tlouwers/buildserver-monitor/buildserver-endpoint/README.md

# buildserver-endpoint
Contains the C/C++ code for the endpoint, the Wemos Lolin D1 mini Pro device.

# buildserver-server
Contains the C# code for the server and (test) client. The server is used to control the endpoint, the client mimics the endpoint and is used for testing.
