tlouwers/buildserver-monitor/buildserver-monitor/manuals/Readme.md

# Information
This folder contains the manual with instructions how to:
* install the development environment
* solder the hardware components
* construct the buildserver monitor kit in general
* program the firmware
* list of components used

##
Documentation is written in LibreOffice v6.4, intended as large word document.
