tlouwers/buildserver-monitor/buildserver-endpoint/manuals/Buildserver-server.odt

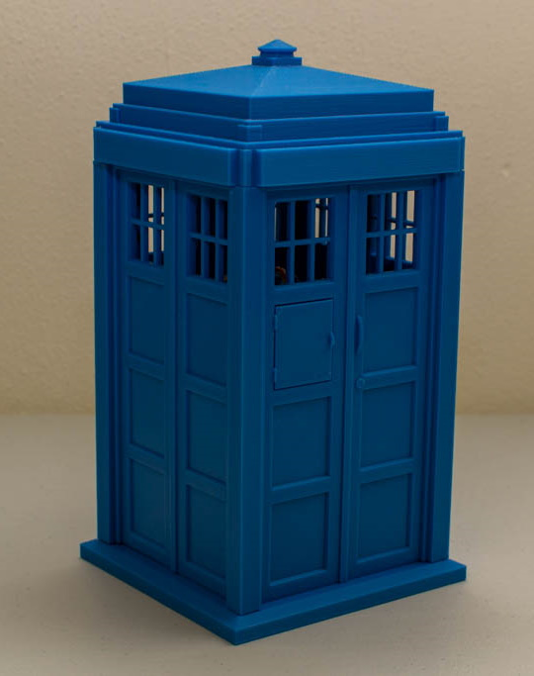
[picture p1: figure]

Buildserver-endpoint

# Idea and intent

To make better use of the buildserver-monitor, this document describes some upgrades made to the already build system. Consider this a version 2.

By adding some hardware components features are added: a buzzer, a vibration motor and an OLED screen. By changing the behavior in software the buildserver-monitor becomes a buildserver-endpoint: instead of the device polling a Jenkins buildserver it becomes a TCP client which connects to a server application. This server application can use a defined API to send commands to the buildserver-endpoint, things like: turn led 3 on in color blue and with 40% brightness. Or, turn buzzer on for 500 milliseconds, then 500 milliseconds silence and repeat for 10 times.

An example server application is provided to show how this API is used. It can control a single buildserver-endpoint, although other server application may support many clients at once.

# Build Environment

To make development more pleasant a switch from Arduino IDE (https://www.arduino.cc/en/software) to PlatformIO (https://platformio.org/platformio-ide) is made. PlatformIO is a plugin for Visual Studio Code (https://code.visualstudio.com/), a description how to install it can be found here (https://docs.platformio.org/en/latest/integration/ide/vscode.html#ide-vscode).

The buildserver-endpoint firmware is build using this IDE.

For the example Server application C# is used (on Windows). For this an old version of Visual Studio Community (2013) (http://go.microsoft.com/?linkid=9863609) is used in combination with a single package (MetroModernUI (https://www.nuget.org/packages/MetroModernUI)) to make the interface look a bit better.

The intent is for the user to write a server application in the language of choice: this is the fun part as you now have full control of the buildserver-endpoint.

# Battery

According to the ESP8266EX datasheet the ESP chip has a single ADC input pin (TOUT), which

can measure a range of 0..1,0V with 10 bit precision.

The Wemos Lonin D1 mini Pro has this pin connected via a voltage divider (see the schematic):

A0 - this is the pin the user can measure, this is in range 0..3,2V

ADC - this is the pin on the ESP chip, this is in range 0..1,0V

The pin ADC (or TOUT) can be found in the schematic of the Wemos board here (https://www.wemos.cc/en/latest/_static/files/sch_d1_mini_pro_v2.0.0.pdf).

To measure the battery we make use of a voltage divider on the board which brings the battery voltage (between 0V and 4.2V) into the range the ADC pin can handle.

When looking in the schematic (See the Battery segment) there are 2 ways to get a voltage on the ADC pin:

- Do NOT connect SJ1 (2 pads on the back of the board). This allows use of the A0 pin, which has a range of 0V .. 3.2V, the voltage divider R1 and R2 brings this into range for the ADC pin.

See: https://www.allaboutcircuits.com/tools/voltage-divider-calculator/

In the schematic of the website Vin is A0, Vout is ADC.

- Connect SJ1 (2 pads on the back of the board). This allows use of Vbat (the actual battery voltage) which is put via the voltage divider to ADC. Here resistor R17 is put in series with R1 (added to, effectively making it a single resistor). Pin A0 should not be used.

The default for measuring the battery is connecting SJ1.

The range (Vbat) becomes 0V .. 4,5V. The charger circuit will make sure the battery charge does not go above 4,2V for the LiPo battery.

Calculating the ADC count:

Count = (Vout * ADCbits) / Vmax_adc --> Count = (Vout * 1023) / 1,0V

To get from ADC count back to the actual battery voltage, we can use the following formula:

V = Count * (Vmax_adc / ADCbits) --> V = Count * (1,0V / 1023)

As we do not want to know the voltage on the ADC pin, we multiply with Vmax_bat, the maximum

voltage as available on Vbat. V = Count * (Vmax_adc / ADCbits) * Vbat --> V = Count * (1,0V / 1023) * 4,5V --> V = Count * 0.0043988270

To map this to a % full lookup table is used where the battery characteristics are included.

Typically, a LiPo battery is considered full at 4,15V, the electronics starts to fail around 3,4V and

the internal battery protection will disconnect the battery at 3,0V. This means we map the % full

on a range of 4.15V (100% full) down to 3,4V (0% full).

https://www.electro-tech-online.com/threads/linear-interpolation-and-lookup-tables-c.147507/

If using linear interpolation on a single segment, we can use a simplified calculation:

float interpolate_segment(float x0, float y0, float x1, float y1, float x)

{

float t;

if (x <= x0) { return y0; }

if (x >= x1) { return y1; }

t = (x-x0);

t /= (x1-x0);

return y0 + t*(y1-y0);

}

With x0 as 3,4V, x1 as 4,15V, y0 as 0% and y1 as 100%, it now becomes:

float calculate_percentage(float x)

{

if (x <= 3.4) { return 0.0; }

if (x >= 4.2) { return 100.0; }

return ( (x - 3.4) / (4.15 - 3.4) ) * 100;

}
