tlouwers/buildserver-monitor/buildserver-endpoint/manuals/Readme.md

# Information
This folder contains the manual with instructions how to:
* install the development environment
* use the buildserver-monitor hardware in a different way
* program the firmware for the buildserver-endpoint
* provide an example Server application in C#
* use the API to be able to control the buildserver-endpoint

##
Documentation is written in LibreOffice v7.3, intended as large word document.
