tlouwers/buildserver-monitor/(commit log)

2020-01-28 Create initial application structure.
    Add various classes: logging, leds, application, statemachine.
    Add statemachine and move handling into Application class.
    Add gitignore file.
    Add doxygen configuration file.
    Update demo to display some colors on a 5 pixel strand.
2020-01-28 Add doxygen comments.
    Add check for the leds if they initialized, before taking an action on the library used.
    Rename folder to allow using the Arduino IDE directly from the *.ino file in the repository.
2020-01-29 Add separate 'wifi_config' file.
    Take maximum wifi connect timeout into account.
    Increase NeoPixel strand length to 8 (default).
    Add delay when encountering Error state.
    [Application.cpp, WifiConnection.cpp, config.h, wifi_config.h]
2020-01-30 Add FakeLeds simulation class.
    Add option to use either real or simulated leds.
2020-01-31 http request, json parsing and displaying
    can send a http request to jenkins and receive a job status in json format. this json can then be parsed and the leds can be turned on accordingly.
2020-02-03 removed prints, improved naming, added destructor delete and added http configuration validation
2020-03-02 Add BOM (bill of material) document.
2020-03-02 Add Power Circuit document.
2020-03-24 Initial NeoPixel assembly document.
2020-04-30 Add photos of the ESP-01 and USB programmer board.
2020-05-12 Improve board manager url picture.
2020-06-02 Remove some magic numbers (make them configurable).
    Close WiFi and reset on error. Initial state diagram added to Architecture document.
    [Application.cpp, Application.hpp, timings.hpp]
2020-07-02 Fix possible null dereference and some spelling items in the Architecture document.
    [WifiConnection.cpp]
2020-09-08 Merge documents together, this to be easier to read.
    Added a section on how to connect the LED strand with the power circuit and added a switch to turn the power on/off.
2020-12-15 Add assembly photos
    Also update descriptions such that only 4 instead of 8 leds are used.
2022-05-09 Update after HW switch to Wemos D1 mini Pro.
    Minor code updates, doxygen fixes.
    Initial document update due to simplified electronics.
    [Application.cpp, FakeHttpClient.hpp, FakeWifiConnection.hpp, IHttpClient.hpp, ILeds.hpp, ILogging.hpp, config.h]
2022-05-10 Update the manual with more assembly photos.
    Add light sleep mode, poll build status once per minute. Spelling fixes, cleanups, make error status more clear to user.
    [Application.cpp, Leds.cpp, Logging.cpp, WifiConnection.cpp, httpClient.cpp, http_config.h, timings.hpp, wifi_config.h]
2022-05-12 Handle authentication properly, fix JSON parsing.
    Robustness improvements and code cleanups. Update documentation.
    [Application.cpp, Application.hpp, FakeLeds.hpp, Leds.cpp, Leds.hpp, Logging.cpp, Logging.hpp, StateMachine.hpp]
2022-05-13 Implement light sleep mode to save power.
    Dim the leds a bit to save power.
2022-05-13 Update BOM in documentation.
2022-05-19 Add led status description to manual
2022-05-19 Add section on how the measure the battery and get to a % full.
2022-05-20 Intermediate commit to start with folder structure for the endpoint.
    Add interfaces to Leds and Timer class.
2022-05-20 Add interfaces to Battery, Buzzer and Vibration classes.
    Add more logging, add error handler (used if Init() fails).
    [Application.cpp, Application.hpp, Battery.cpp, Buzzer.cpp, Buzzer.hpp]
2022-05-24 Check the On/Off for the buzzer and vibration motor with real components.
    [Buzzer.cpp, Vibration.cpp]
